FakieSui/Billarduino/README.md

# Billarduino
Self-playing Billiard based on Arduino &amp; PixyCam

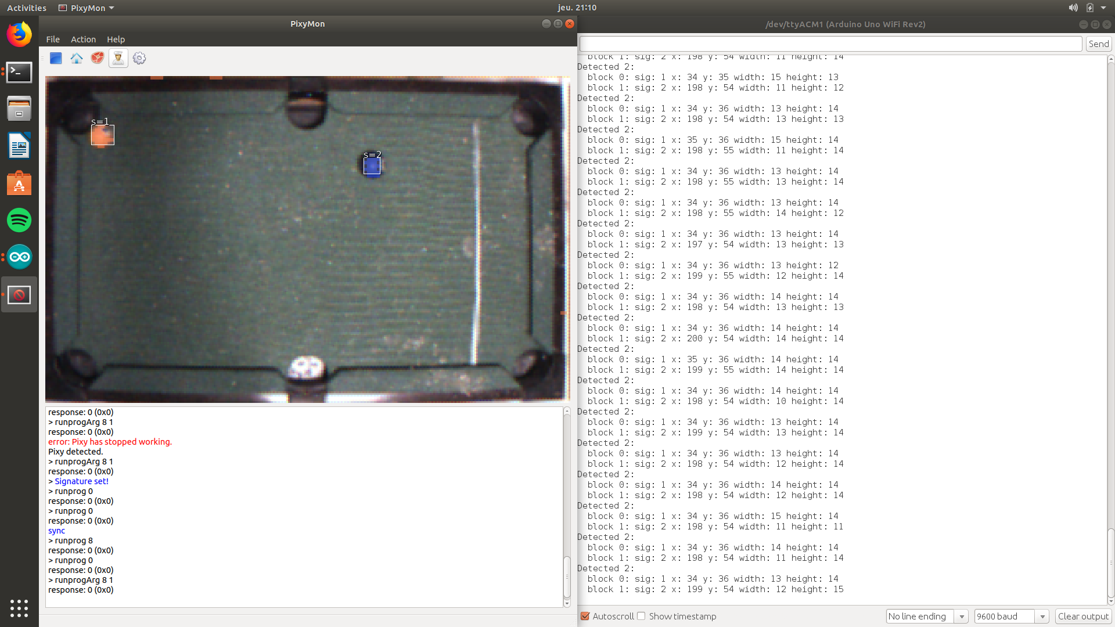
[picture p1: rapports/images/pictural_ball_scrap.png]


## Soutenance

https://docs.google.com/presentation/d/1xzkSd1WUeLzVVLRjQoTh607-S0mNEbuHv8M70IEcq6Y/edit?usp=sharing

## Rapport du projet

https://github.com/AntoineFacq/Billarduino/blob/master/rapports/Rapport%20du%20projet.pdf

## Authors
[Antoine FACQ](https://github.com/AntoineFacq/) & [Maxime Lafont-Trevisan](https://github.com/MaximeLafont/)

## Remerciements

Merci à Lyonel Dahan pour son aide précieuse, et son FabLab' maison.
