FakieSui/Billarduino/rapports/planning.ods

Taches \ Séances | 03/12/18 | 10/12/18 | 17/12/18 | 07/01/19 | 14/01/2019 | 21/01/19 | 06/02/19 | 13/02/19 | 27/02/19 | 06/03/19 | 13/04/2019
Test PixyCam
Rédaction du programme (avec portions de code test)
Construction du module mobile
Construction de la PixyPole (perche PixyCam)
Construction du rail du module
Finalisation du programme
Tests et réglages d’appoint
