FakieSui/Billarduino/rapports/maxime.md

Rôle personnel:

Conception de la partie algorithmique du code qui permettra le calcul de l'angle du moteur pas à pas. Et aussi le nombre de tours que devra effectuer le moteur 12 Volt Nema 17 qui correspondra en fait à la distance de parcourt de celui-ci.

Séance du Lundi 3 Décembre (1)

Lors de cette première scéance avec la pixycam, nous avons réussi à identifier des objets de différentes couleurs (rouge, bleu et jaune).
Dans un premier temps on a fait l'aquisition des objets, et ensuite la caméra peut détecter les objets n'importe où dans son champs de vision.
Cela nous permettra pour les scéances futures d'identifier les différentes boules de billard et surtout de déterminer leurs positions en fonction du champs de vision rectangulaire de la pixycam.
Schéma de l'acquisition des différents objets:



Séance du Lundi 10 décembre (2):

Maintenant que nous avons en possession notre billard, nous avons déterminé l'objectif précis de notre projet.
L'objectif est de pouvoir mettre une bille objet n'importe où dans le billard et, grâce à une bille blanche que nous allons propulser sur la bille objet, la bille objet ira automatiquement dans le trou.
Nous n'allons utiliser que deux trous sur les six trous du billard; deux trous d'extrémité.
Nous nous sommes fixé comme objectif de mi-projet de prendre toujours la même position de la boule blanche.
En revanche, pour la fin de projet, la bille blanche pourra être placée sur une ligne le long de la largeur du billard.



Séance du lundi 17 décembre (3):

Lors de cette séance nous avons principalement trouvé les équations mathématiques qui nous permettrons de calculer les endroits précis d'impact voulu. Le principe est simple:
à partir des coordonées de la bille blanche et de la bille objet (en deux dimension, coordonnées cartésiens), nous pouvons calculer les coordonnées de "tire", c'est à dire où exactement nous devons lancer la bille blanche. Cette position ne sera rien d'autre que le prolongement d'une distance du diamètre des boules du vecteur du trou vers la bille objet en partant de la bille objet.
Pour la rotation du module, c'est un simple calcul d'angle en fonctions des coordonnées des deux billes et du trou.
Notre recherche est schématisé, légendé et expliqué sur les photos ci-dessous.





Séance du lundi 14 janvier (4):

Nous avons récupéré une grande partie du matériel nécéssaire à la conception du projet:

-Nous avons récupéré un écrou, une prise à roulement et deux fixations pour la tige fileté.

-Découpage de la tige coulisante pour envoyer l'impact avec un coulisseau.

-Découpage de la tige fileté pour supporter le module de translation.

-Un moteur 12 Volt Nema 17 avec son coupleur.

Séance du lundi 21 janvier (5):

Nous avons fait marcher les deux mouvements du module en même temps:

-Rotation liée au moteur pas à pas.

-Rotation du moteur 12 Volt Nema 17 pour la translation du module.

La vidéo est disponible sur Youtbe:

https://l.facebook.com/l.php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
