FakieSui/Billarduino/rapports/art-state.md

# ÉTAT DE L'ART

1) Self-Playing Billard

Tout d'abord, il semble important d'indiquer que le domaine du billard n'est pas propice à l´élaboration de projets ARDUINO.
À ce jour, nous ne référençons qu'un seul projet (audacieux) de billard avec arduino que nous avons découvert par hasard bien après avoir eu l'idée.
Il s'agit d'un "SELF-PLAYING BILLIARD" (billard qui joue tout seul)
Le principe est identique au notre, mais est plus avancé :
- le billard n´est composé que d'un pied pour permettre de déplacer un robot en rotation autours du billard et de s´affranchir du problème des quatre pieds
- la pixycam (que nous utilisons également) est fixée sur le module lui même est fait l´acquisition à la première personne
- le billard est simplifié : il est composé de palets circulaires de couleurs uniformes de façon à facilité le travail de la PixyCam

2) Robot à deux bras

Ensuite, en creusant un peu plus sur le net, on a pu découvrir un robot capable de jouer au billard avec deux bras, soit un système infiniment plus complexe que le notre dans la mesure de l'investissement de temps et d'argent et par rapport à la contrainte de l'arduino qui rendrait cela très complexe http://www.semageek.com/un-robot-a-deux-bras-capable-de-jouer-au-billard-a-la-perfection/
