FakieSui/Billarduino/rapports/images/pixy_pole.jpg

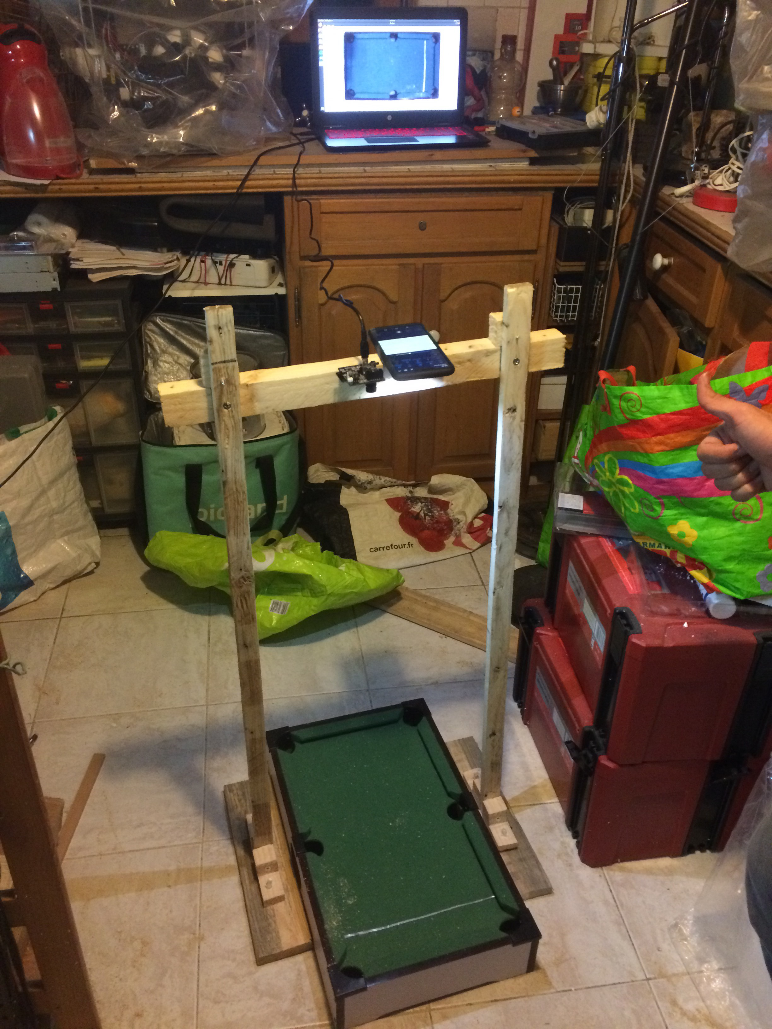
rapports/images/pixy_pole.jpg
