FakieSui/Billarduino/material/list.md

# Material list to build the Billarduino

## Hard Material
- Planches de bois (issues de palettes)

## Acquisition:
- CMUcam5 PixyCam 1.3, 2013

## Motors & rods:
- Tige filetée
- Tige coulissante
- Ecrou (pour la tige filetée)
- Prise à roulement (pour la tige filetée)
- Fixations (pour la tige coulissante) x2
- Coulisseau (pour la tige coulissante)
- Moteur pas à pas 12V Nema 17
- Coupleur (pour le moteur)

## Remote control system (second part):
- HC-06 Bluetooth
- SONY Xperia M2 (Android Device)
- "Bluetooth Electronics" Android application
