FakieSui/Billarduino/(commit log)

2018-12-03 Create list.md
    Describing material list
2018-12-26 Travail de noël
2019-01-30 Ajout du travail des vacances
    Rédaction du programme et application des formules mathématiques pour les calculs d'angle et de distance
2019-02-27 Redefinition de l'origine du repère + resolution de problèmes mineurs
